crazypatoto/pppc-usb-hub/PCB/pppc_usb_hub/BOM.xlsx

Reference | Value | Datasheet | Footprint | Qty | DNP | MSRP | Total
C1,C2,C3,C4,C5,C11,C25 | 0.1uF | https://www.lcsc.com/product-detail/Multilayer-Ceramic-Capacitors-MLCC-SMD-SMT_Samsung-Electro-Mechanics-CL10B104KB8NNNC_C1591.html | Capacitor_SMD:C_0201_0603Metric | 7 |  | 0.0024 | 3.8712
C6,C7,C23,C24 | 20pF | https://www.lcsc.com/product-detail/Multilayer-Ceramic-Capacitors-MLCC-SMD-SMT_FH-Guangdong-Fenghua-Advanced-Tech-0603CG200F500NT_C165732.html | Capacitor_SMD:C_0201_0603Metric | 4 |  | 0.014
C8,C9,C10,C20 | 10uF | https://www.lcsc.com/product-detail/Multilayer-Ceramic-Capacitors-MLCC-SMD-SMT_Samsung-Electro-Mechanics-CL10A106MQ8NNNC_C1691.html | Capacitor_SMD:C_0201_0603Metric | 4 |  | 0.0044
C12,C13,C14,C22 | 220uF | https://www.lcsc.com/product-detail/Solid-Capacitors_Honor-Elec-HV1E227M0607PZ_C5246541.html | Capacitor_SMD:CP_Elec_6.3x7.7 | 4 |  | 0.1408
C15 | 4.7uF | https://www.lcsc.com/product-detail/Multilayer-Ceramic-Capacitors-MLCC-SMD-SMT_Samsung-Electro-Mechanics-CL10A475KQ8NNNC_C8032.html | Capacitor_SMD:C_0201_0603Metric | 1 |  | 0.0041
C16,C17 | 100nF | https://www.lcsc.com/product-detail/Multilayer-Ceramic-Capacitors-MLCC-SMD-SMT_Samsung-Electro-Mechanics-CL10B104KB8NNNC_C1591.html | Capacitor_SMD:C_0201_0603Metric | 2 |  | 0.0024
C18 | 10nF | https://www.lcsc.com/product-detail/Multilayer-Ceramic-Capacitors-MLCC-SMD-SMT_YAGEO-CC0603KRX7R9BB103_C100042.html | Capacitor_SMD:C_0201_0603Metric | 1 |  | 0.0019
C19 | 1uF | https://www.lcsc.com/product-detail/Multilayer-Ceramic-Capacitors-MLCC-SMD-SMT_Samsung-Electro-Mechanics-CL10A105KB8NNNC_C15849.html | Capacitor_SMD:C_0201_0603Metric | 1 |  | 0.0042
C21 | 22uF | https://www.lcsc.com/product-detail/Tantalum-Capacitors_KEMET-T491A226K006AT_C118989.html | Capacitor_Tantalum_SMD:CP_EIA-3216-10_Kemet-I | 1 |  | 0.0801
D1 | 1N4007 | https://www.lcsc.com/product-detail/Diodes-General-Purpose_MSKSEMI-1N4007-A7_C2902912.html | Diode_SMD:D_SOD-123F | 1 |  | 0.0038
D2 | POWER | https://www.lcsc.com/product-detail/Light-Emitting-Diodes-LED_XINGLIGHT-XL-1608UOC-06_C965800.html | LED_SMD:LED_0201_0603Metric | 1 |  | 0.0051
D3 | USB1 | https://www.lcsc.com/product-detail/Light-Emitting-Diodes-LED_XINGLIGHT-XL-1608UWC-04_C965808.html | LED_SMD:LED_0201_0603Metric | 1 |  | 0.0053
D4 | USB2 | https://www.lcsc.com/product-detail/Light-Emitting-Diodes-LED_XINGLIGHT-XL-1608UWC-04_C965808.html | LED_SMD:LED_0201_0603Metric | 1 |  | 0.0053
D5 | USB3 | https://www.lcsc.com/product-detail/Light-Emitting-Diodes-LED_XINGLIGHT-XL-1608UWC-04_C965808.html | LED_SMD:LED_0201_0603Metric | 1 |  | 0.0053
D6 | RELAY | https://www.lcsc.com/product-detail/Light-Emitting-Diodes-LED_XINGLIGHT-XL-1608UWC-04_C965808.html | LED_SMD:LED_0201_0603Metric | 1 |  | 0.0053
F1 | Polyfuse | https://www.lcsc.com/product-detail/Resettable-Fuses_LUTE-0805L125-6NR_C7499987.html | Capacitor_SMD:C_0805_2012Metric | 1 |  | 0.0584
FB1,FB2 | BLM21PG221SN1D | https://www.lcsc.com/product-detail/Ferrite-Beads_Murata-Electronics-BLM21PG221SN1D_C85840.html | Fuse:Fuse_0805_2012Metric | 2 |  | 0.0148
J1,J2 | USB_C_Signal | https://www.lcsc.com/product-detail/USB-Connectors_SHOU-HAN-TYPE-C-16PIN-2MD-073_C2765186.html | PCBLIB_USB-C-SMD_TYPE-C-6PIN-2MD-073_2024-05-18:USB-C-SMD_TYPE-C-6PIN-2MD-073 | 2 |  | 0.0501
J3 | USB_A_1 | https://www.lcsc.com/product-detail/USB-Connectors_SHOU-HAN-AF-10-0-HC6-3_C456017.html | PCBLIB_USB-A-TH_AF-10.0-HC6.3_2024-05-20:USB-A-TH_AF-10.0-HC6.3 | 1 |  | 0.0362
J4 | USB_A_2 | https://www.lcsc.com/product-detail/USB-Connectors_Ckmtw-Shenzhen-Cankemeng-U-USBAS04P-F001_C386737.html | PCBLIB_USB-A-TH_USB-M-22_2024-05-19:USB-A-TH_USB-M-22 | 1 |  | 0.1504
J5 | USB_A_3 | https://www.lcsc.com/product-detail/USB-Connectors_Ckmtw-Shenzhen-Cankemeng-U-USBAS04P-F001_C386737.html | PCBLIB_USB-A-TH_USB-M-22_2024-05-19:USB-A-TH_USB-M-22 | 1 |  | 0.1504
J6 | Con_Relay | https://www.lcsc.com/product-detail/Screw-terminal_DORABO-DB128L-5-08-3P-OG-S_C430604.html | PCBLIB_CONN-TH_3P-P5.08_DB128L-5.08-3P-OG-S_2024-05-19:CONN-TH_3P-P5.08_DB128L-5.08-3P-OG-S | 1 |  | 0.1801
J7 | Conn_UART | https://www.lcsc.com/product-detail/Pin-Headers_Hanbo-Electronic-HB-PH3-25415PB2GOP_C6332198.html | Connector_PinHeader_2.54mm:PinHeader_1x05_P2.54mm_Vertical | 1 |  | 0.0223
J8 | Conn_Debug | ~ | Connector_PinHeader_2.54mm:PinHeader_1x03_P2.54mm_Vertical | 1
K1 | Relay | https://www.lcsc.com/product-detail/Power-Relays_Ningbo-Songle-Relay-SRD-05VDC-SL-C_C35449.html | Relay_THT:Relay_SPDT_SANYOU_SRD_Series_Form_C | 1 |  | 0.3124
Q1 | DMG2305UX | https://www.lcsc.com/product-detail/MOSFETs_TECH-PUBLIC-DMG2305UX_C2940629.html | Package_TO_SOT_SMD:SOT-23 | 1 |  | 0.0517
Q2 | DMMT5401 | https://www.lcsc.com/product-detail/Bipolar-Transistors-BJT_Diodes-Incorporated-DMMT5401-7-F_C154733.html | Package_TO_SOT_SMD:SOT-23-6 | 1 |  | 0.1683
Q3 | AO3400A | https://www.lcsc.com/product-detail/MOSFETs_UMW-Youtai-Semiconductor-Co-Ltd-AO3400A_C347475.html | Package_TO_SOT_SMD:SOT-23 | 1 |  | 0.0278
R1,R2,R3 | 4.53k | https://www.lcsc.com/product-detail/Chip-Resistor-Surface-Mount_FH-Guangdong-Fenghua-Advanced-Tech-RS-03K4531FT_C321916.html | Resistor_SMD:R_0201_0603Metric | 3 |  | 0.0012
R4,R5,R12,R13 | 5.1k | https://www.lcsc.com/product-detail/Chip-Resistor-Surface-Mount_UNI-ROYAL-Uniroyal-Elec-0603WAF5101T5E_C23186.html | Resistor_SMD:R_0201_0603Metric | 4 |  | 0.0010
R6,R7,R8,R19,R20,R22 | 10k | https://www.lcsc.com/product-detail/Chip-Resistor-Surface-Mount_UNI-ROYAL-Uniroyal-Elec-0603WAF1002T5E_C25804.html | Resistor_SMD:R_0201_0603Metric | 6 |  | 0.0009
R9,R10,R11 | 0R | ~ | Resistor_SMD:R_0201_0603Metric | 3
R14,R15,R16,R17,R18 | 330 | https://www.lcsc.com/product-detail/Chip-Resistor-Surface-Mount_UNI-ROYAL-Uniroyal-Elec-0603WAF3300T5E_C23138.html | Resistor_SMD:R_0201_0603Metric | 5 |  | 0.001
R21 | 47k | https://www.lcsc.com/product-detail/Chip-Resistor-Surface-Mount_UNI-ROYAL-Uniroyal-Elec-0603WAF4701T5E_C23162.html | Resistor_SMD:R_0201_0603Metric | 1 |  | 0.001
SW1 | USB1 | https://www.lcsc.com/product-detail/Tactile-Switches_G-Switch-GT-TC020B-H035-L05_C17179534.html | PCBLIB_SW-SMD_GT-TC020B-H035-L05_2024-05-21:SW-SMD_GT-TC020B-H035-L05 | 1 |  | 0.0726
SW2 | USB2 | https://www.lcsc.com/product-detail/Tactile-Switches_G-Switch-GT-TC020B-H035-L05_C17179534.html | PCBLIB_SW-SMD_GT-TC020B-H035-L05_2024-05-21:SW-SMD_GT-TC020B-H035-L05 | 1 |  | 0.0726
SW3 | USB3 | https://www.lcsc.com/product-detail/Tactile-Switches_G-Switch-GT-TC020B-H035-L05_C17179534.html | PCBLIB_SW-SMD_GT-TC020B-H035-L05_2024-05-21:SW-SMD_GT-TC020B-H035-L05 | 1 |  | 0.0726
SW4 | BOOT0 | https://www.lcsc.com/product-detail/Tactile-Switches_XKB-Connection-TS-1101-C-W_C318938.html | PCBLIB_SW-SMD_L6.0-W3.3-LS8.0_2024-05-19:SW-SMD_L6.0-W3.3-LS8.0 | 1 |  | 0.0323
SW5 | RESET | https://www.lcsc.com/product-detail/Tactile-Switches_XKB-Connection-TS-1101-C-W_C318938.html | PCBLIB_SW-SMD_L6.0-W3.3-LS8.0_2024-05-19:SW-SMD_L6.0-W3.3-LS8.0 | 1 |  | 0.0323
U1,U2,U3 | MT9700 | https://www.lcsc.com/product-detail/span-style-background-color-ff0-Power-span-Distribution-Switches_XI-AN-Aerosemi-Tech-MT9700_C89855.html | PCBLIB_SOT-23-5_L3.0-W1.7-P0.95-LS2.8-BR_2024-05-18:SOT-23-5_L3.0-W1.7-P0.95-LS2.8-BR | 3 |  | 0.0356
U4 | SL2.1s | https://www.lcsc.com/product-detail/USB-Converters_CoreChips-SL2-1s_C2684433.html | PCB_NEW_PCB_2024-05-14:SSOP-16_L4.6-W2.6-P0.53-LS4.0-BL | 1 |  | 0.205
U5 | AMS1117-3.3 | https://www.lcsc.com/product-detail/Linear-Voltage-Regulators-LDO_Advanced-Monolithic-Systems-AMS1117-3-3_C6186.html | Package_TO_SOT_SMD:SOT-223-3_TabPin2 | 1 |  | 0.1298
U6 | STM32F042F6Px | https://www.lcsc.com/product-detail/Microcontroller-Units-MCUs-MPUs-SOCs_STMicroelectronics-STM32F042F6P6TR_C2969989.html | Package_SO:TSSOP-20_4.4x6.5mm_P0.65mm | 1 |  | 1.1458
XTAL1,XTAL2 | 12MHz | https://www.lcsc.com/product-detail/Crystals_YXC-X322512MSB4SI_C9002.html | PCBLIB_OSC-SMD_4P-L3.2-W2.5-BL_2024-05-18:OSC-SMD_4P-L3.2-W2.5-BL | 2 |  | 0.0571
