crazypatoto/pppc-usb-hub/PCB/3d_models/TactileButton(6x3,5mm)_SMD.stp

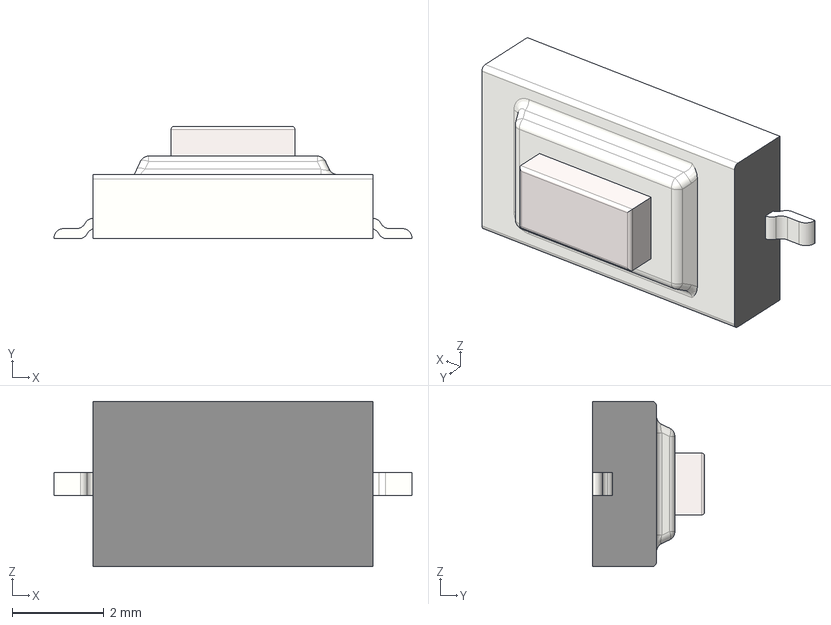
[picture p1: CAD file, 2024-05-30]
PCB/3d_models/TactileButton(6x3,5mm)_SMD.stp
7.80 x 2.45 x 3.60 mm
