crazypatoto/pppc-usb-hub/PCB/SLOT.dxf

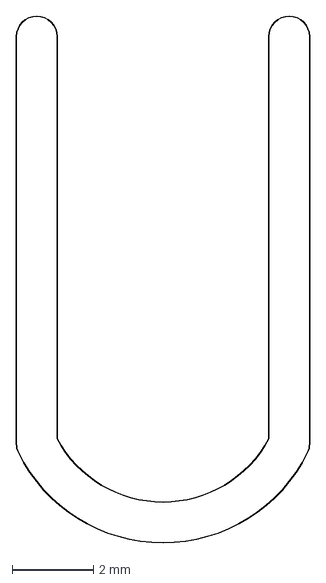
[picture p2: CAD file, 2024-05-30]
PCB/SLOT.dxf
7.20 x 12.9 mm
