crazypatoto/pppc-usb-hub/PCB/3d_models/dg-301-5_0.step

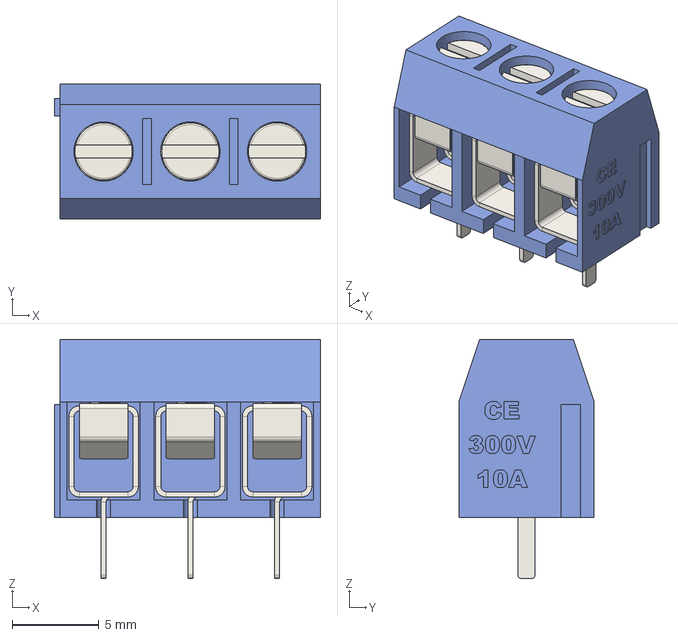
[picture p3: CAD file, 2024-05-22]
PCB/3d_models/dg-301-5_0.step
15.3 x 7.80 x 13.8 mm
