crazypatoto/pppc-usb-hub/PCB/PCB_Outline.dxf

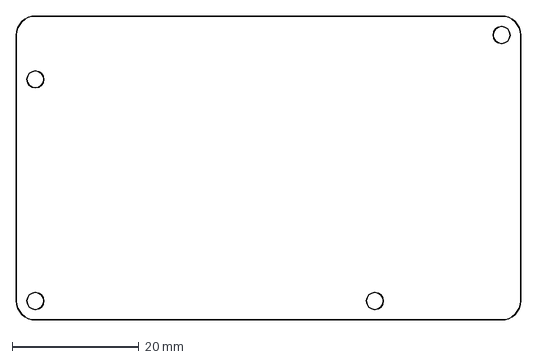
[picture p4: CAD file, 2024-05-30]
PCB/PCB_Outline.dxf
79.6 x 48.0 mm
