crazypatoto/pppc-usb-hub/PCB/3d_models/usb1125-gf-b.stp

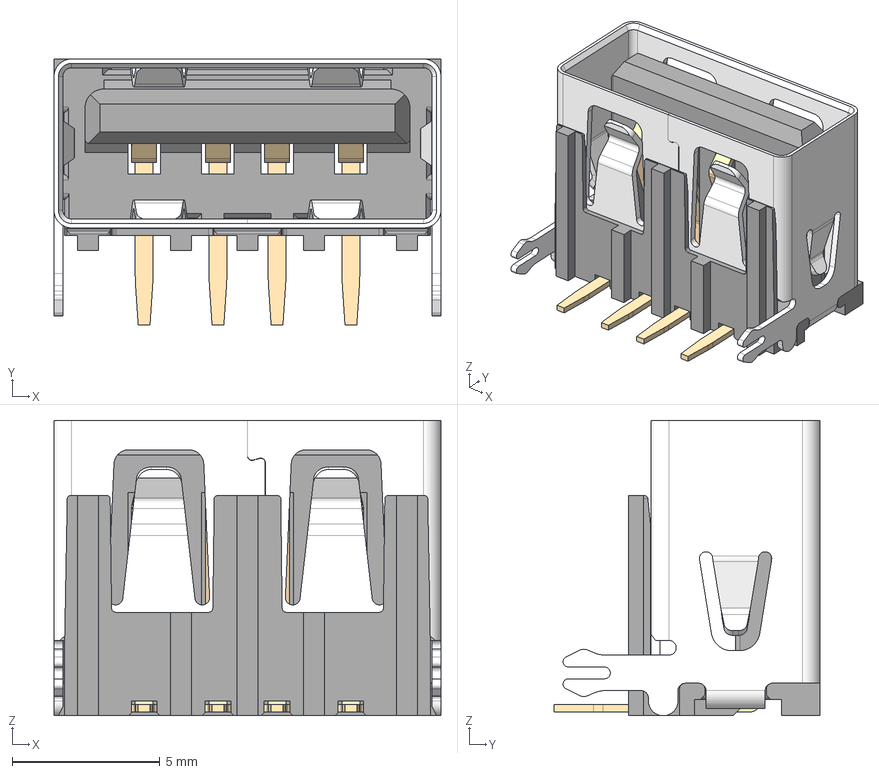
[picture p5: CAD file, 2024-05-22]
PCB/3d_models/usb1125-gf-b.stp
13.1 x 9.01 x 10.0 mm
