crazypatoto/pppc-usb-hub/PCB/3d_models/USB-A-S-F-B-VT.stp

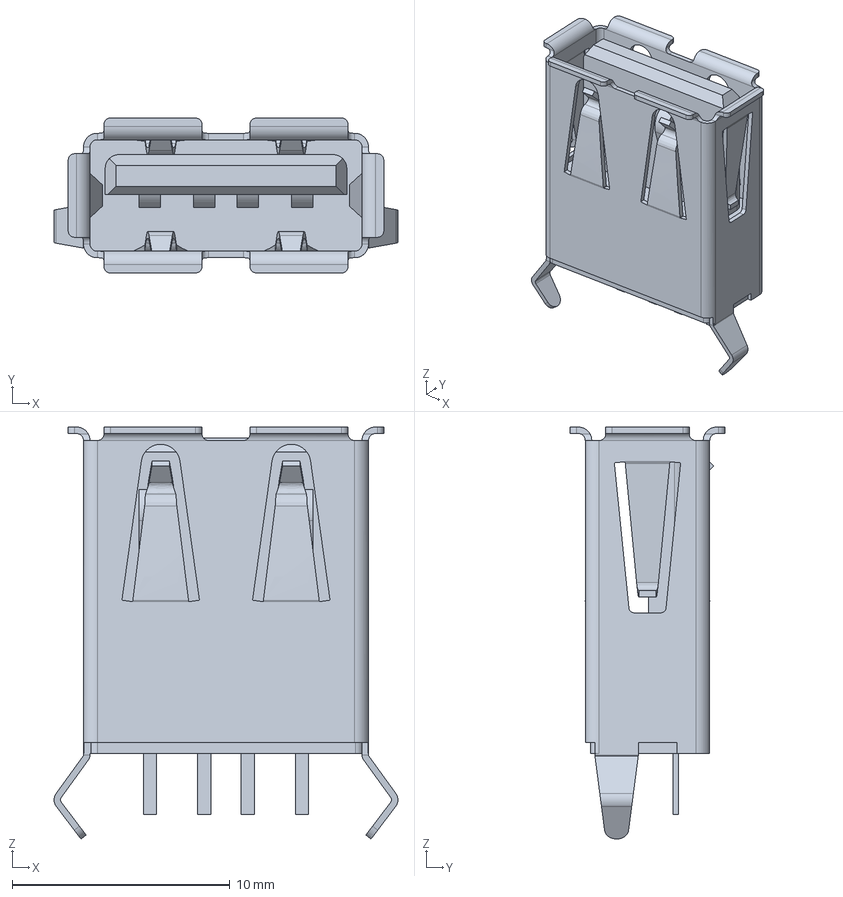
[picture p6: CAD file, 2024-05-22]
PCB/3d_models/USB-A-S-F-B-VT.stp
15.8 x 7.12 x 18.9 mm
