crazypatoto/pppc-usb-hub/PCB/pppc_usb_hub/pppc_usb_hub.kicad_pcb

## KiCad design PCB/pppc_usb_hub/pppc_usb_hub.kicad_pcb (2024-06-25)

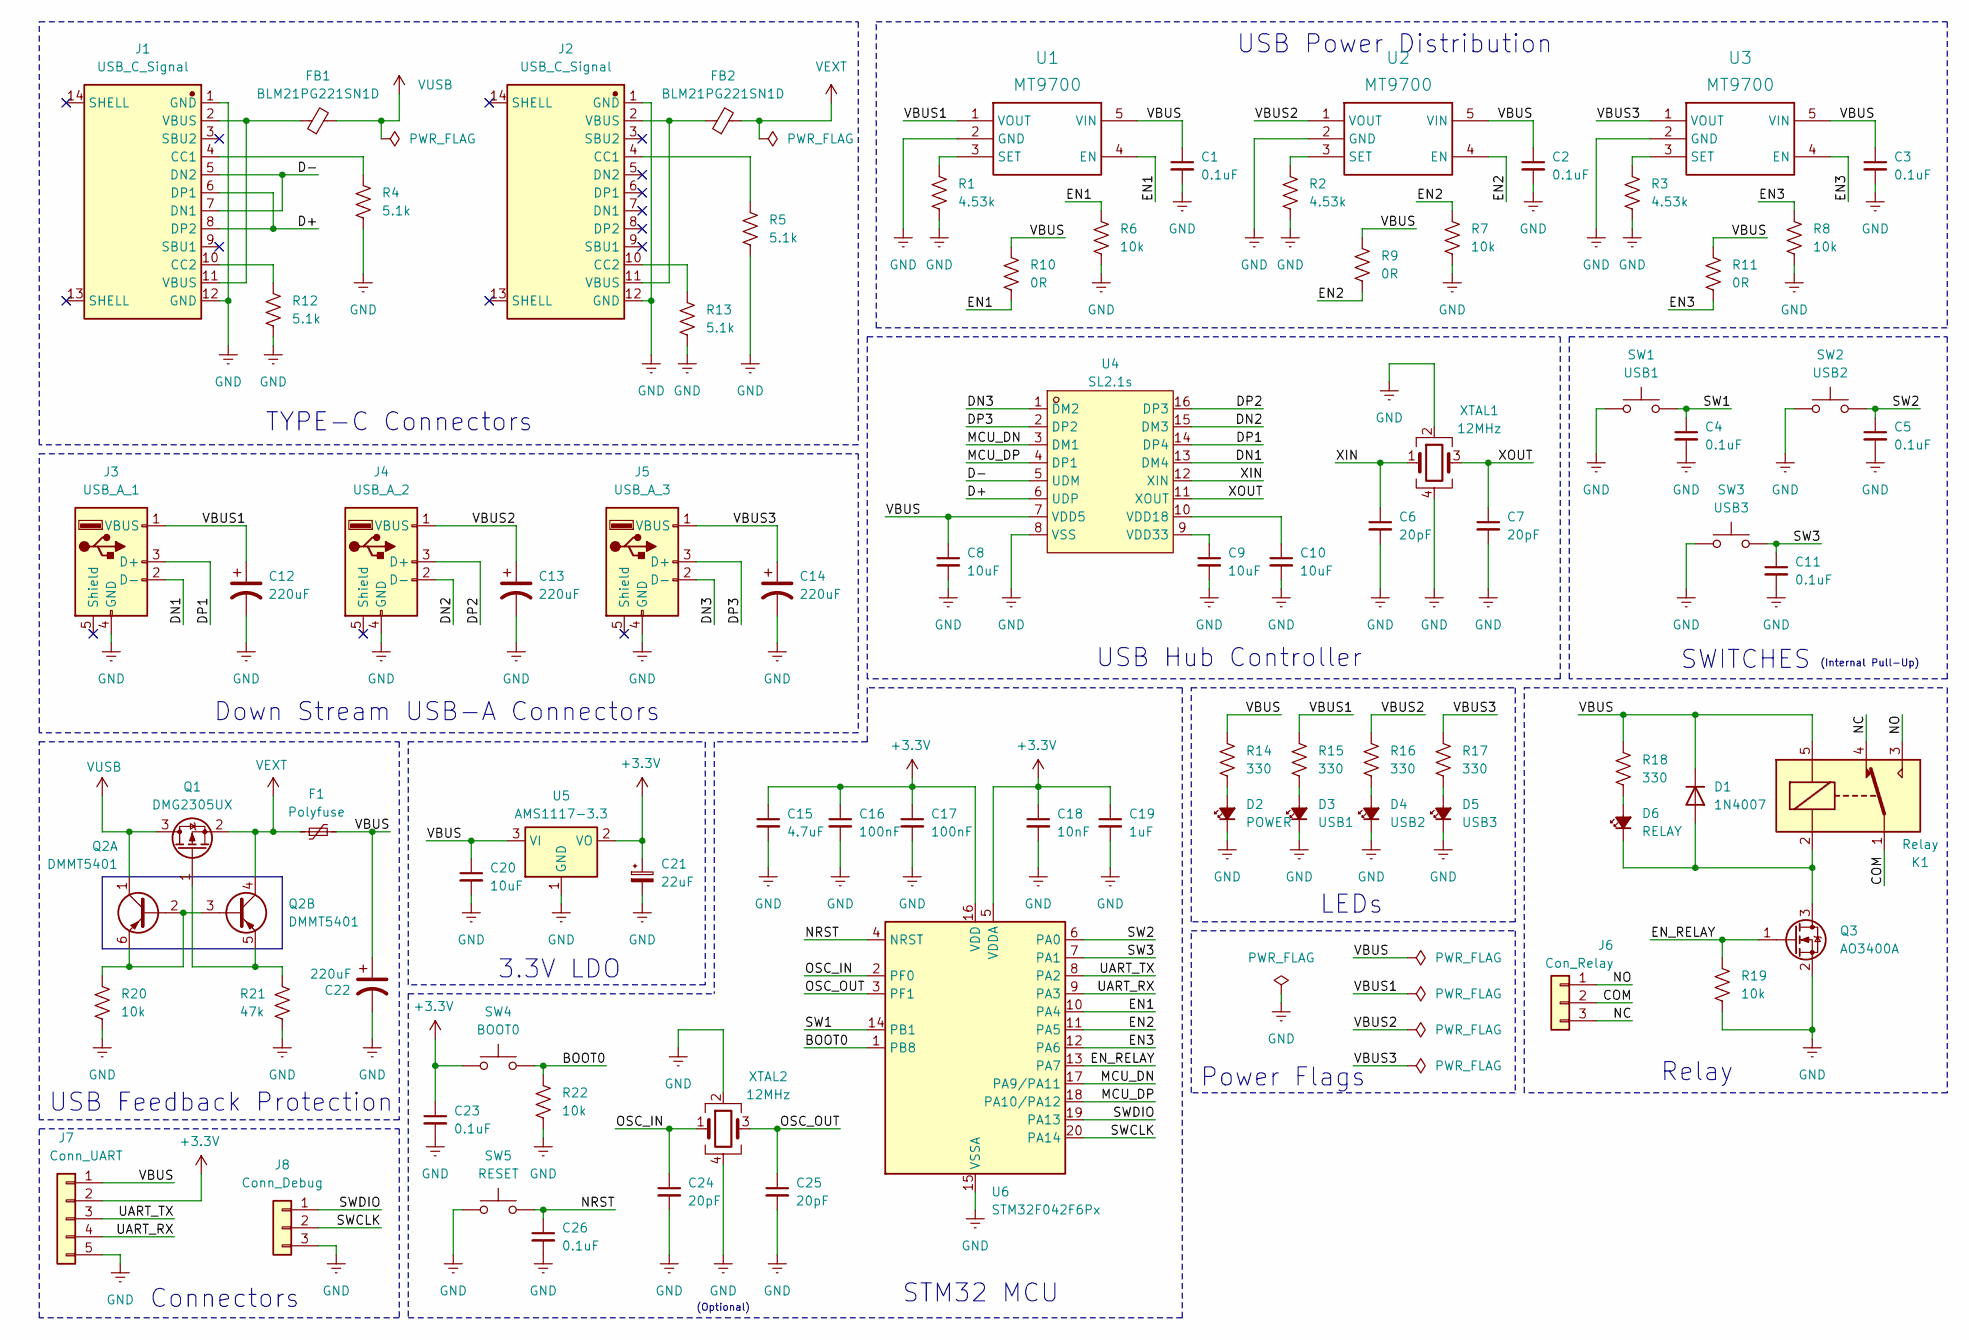
[picture p7: schematic pppc_usb_hub.kicad_sch, Per-Port Power Control USB Hub]

Parts:
C1, C2, C3, C4, C5, C11, C23, C26: 0.1uF; C_0603_1608Metric
C6, C7, C24, C25: 20pF; C_0603_1608Metric
C8, C9, C10, C20: 10uF; C_0603_1608Metric
C12, C13, C14, C22: 220uF; CP_Elec_6.3x7.7
C15: 4.7uF; C_0603_1608Metric
C16, C17: 100nF; C_0603_1608Metric
C18: 10nF; C_0603_1608Metric
C19: 1uF; C_0603_1608Metric
C21: 22uF; CP_EIA-3216-10_Kemet-I
D1: 1N4007; D_SOD-123F
D2: POWER; LED_0603_1608Metric
D3: USB1; LED_0603_1608Metric
D4: USB2; LED_0603_1608Metric
D5: USB3; LED_0603_1608Metric
D6: RELAY; LED_0603_1608Metric
F1: Polyfuse; C_0805_2012Metric
FB1, FB2: BLM21PG221SN1D; Fuse_0805_2012Metric
J1, J2: USB_C_Signal; USB-C-SMD_TYPE-C-6PIN-2MD-073
J3: USB_A_1; USB-A-TH_AF-10.0-HC6.3
J4: USB_A_2; USB-A-TH_USB-M-22
J5: USB_A_3; USB-A-TH_USB-M-22
J6: Con_Relay; CONN-TH_3P-P5.08_DB128L-5.08-3P-OG-S
J7: Conn_UART; PinHeader_1x05_P2.54mm_Vertical
J8: Conn_Debug; PinHeader_1x03_P2.54mm_Vertical
K1: Relay; Relay_SPDT_SANYOU_SRD_Series_Form_C
Q1: DMG2305UX; SOT-23
Q2: DMMT5401; SOT-23-6
Q3: AO3400A; SOT-23
R1, R2, R3: 4.53k; R_0603_1608Metric
R4, R5, R12, R13: 5.1k; R_0603_1608Metric
R6, R7, R8, R19, R20, R22: 10k; R_0603_1608Metric
R9, R10, R11: 0R; R_0603_1608Metric
R14, R15, R16, R17, R18: 330; R_0603_1608Metric
R21: 47k; R_0603_1608Metric
SW1: USB1; SW-SMD_GT-TC020B-H035-L05
SW2: USB2; SW-SMD_GT-TC020B-H035-L05
SW3: USB3; SW-SMD_GT-TC020B-H035-L05
SW4: BOOT0; SW-SMD_GT-TC020B-H035-L05
SW5: RESET; SW-SMD_L6.0-W3.3-LS8.0
U1, U2, U3: MT9700; SOT-23-5_L3.0-W1.7-P0.95-LS2.8-BR
U4: SL2.1s; SSOP-16_L4.6-W2.6-P0.53-LS4.0-BL
U5: AMS1117-3.3; SOT-223-3_TabPin2
U6: STM32F042F6Px; TSSOP-20_4.4x6.5mm_P0.65mm
XTAL1, XTAL2: 12MHz; OSC-SMD_4P-L3.2-W2.5-BL

Connections:
+3.3V: C15.1, C16.1, C17.1, C18.1, C19.1, C21.1, C23.1, J7.2, SW4.2, U5.2 (VO), U6.5 (VDDA), U6.16 (VDD)
/BOOT0: R22.1, SW4.1, U6.1 (PB8)
/COM: J6.2, K1.1
/D+: J1.6 (DP1), J1.8 (DP2), U4.6 (UDP)
/D-: J1.5 (DN2), J1.7 (DN1), U4.5 (UDM)
/DN1: J3.2 (D-), U4.13 (DM4)
/DN2: J4.2 (D-), U4.15 (DM3)
/DN3: J5.2 (D-), U4.1 (DM2)
/DP1: J3.3 (D+), U4.14 (DP4)
/DP2: J4.3 (D+), U4.16 (DP3)
/DP3: J5.3 (D+), U4.2 (DP2)
/EN1: R6.1, R10.2, U1.4 (EN), U6.10 (PA4)
/EN2: R7.1, R9.2, U2.4 (EN), U6.11 (PA5)
/EN3: R8.1, R11.2, U3.4 (EN), U6.12 (PA6)
/EN_RELAY: Q3.1 (G), R19.1, U6.13 (PA7)
/MCU_DN: U4.3 (DM1), U6.17 (PA9/PA11)
/MCU_DP: U4.4 (DP1), U6.18 (PA10/PA12)
/NC: J6.3, K1.4
/NO: J6.1, K1.3
/NRST: C26.1, SW5.1, U6.4 (NRST)
/OSC_IN: C24.1, U6.2 (PF0), XTAL2.1
/OSC_OUT: C25.1, U6.3 (PF1), XTAL2.3
/SW1: C4.1, SW1.1, U6.14 (PB1)
/SW2: C5.1, SW2.1, U6.6 (PA0)
/SW3: C11.1, SW3.1, U6.7 (PA1)
/SWCLK: J8.2, U6.20 (PA14)
/SWDIO: J8.1, U6.19 (PA13)
/UART_RX: J7.4, U6.9 (PA3)
/UART_TX: J7.3, U6.8 (PA2)
/VBUS: C1.1, C2.1, C3.1, C8.1, C20.1, C22.1, D1.1 (K), F1.2, J7.1, K1.5, R9.1, R10.1, R11.1, R14.1, R18.1, U1.5 (VIN), U2.5 (VIN), U3.5 (VIN), U4.7 (VDD5), U5.3 (VI)
/VBUS1: C12.1, J3.1 (VBUS), R15.1, U1.1 (VOUT)
/VBUS2: C13.1, J4.1 (VBUS), R16.1, U2.1 (VOUT)
/VBUS3: C14.1, J5.1 (VBUS), R17.1, U3.1 (VOUT)
/XIN: C6.1, U4.12 (XIN), XTAL1.1
/XOUT: C7.1, U4.11 (XOUT), XTAL1.3
GND: C1.2, C2.2, C3.2, C4.2, C5.2, C6.2, C7.2, C8.2, C9.2, C10.2, C11.2, C12.2, C13.2, C14.2, C15.2, C16.2, C17.2, C18.2, C19.2, C20.2, C21.2, C22.2, C23.2, C24.2, C25.2, C26.2, D2.1 (K), D3.1 (K), D4.1 (K), D5.1 (K), J1.1 (GND), J1.12 (GND), J2.1 (GND), J2.12 (GND), J3.4 (GND), J4.4 (GND), J5.4 (GND), J7.5, J8.3, Q3.2 (S), R1.2, R2.2, R3.2, R4.2, R5.2, R6.2, R7.2, R8.2, R12.2, R13.2, R19.2, R20.2, R21.2, R22.2, SW1.2, SW2.2, SW3.2, SW5.2, U1.2 (GND), U2.2 (GND), U3.2 (GND), U4.8 (VSS), U5.1 (GND), U6.15 (VSSA), XTAL1.2, XTAL1.4, XTAL2.2, XTAL2.4
unnamed: D1.2 (A), D6.1 (K), K1.2, Q3.3 (D)
unnamed: D2.2 (A), R14.2
unnamed: D3.2 (A), R15.2
unnamed: D4.2 (A), R16.2
unnamed: D5.2 (A), R17.2
unnamed: D6.2 (A), R18.2
unnamed: FB1.1, J1.2 (VBUS), J1.11 (VBUS)
unnamed: FB2.1, J2.2 (VBUS), J2.11 (VBUS)
unnamed: J1.4 (CC1), R4.1
unnamed: J1.10 (CC2), R12.1
unnamed: J2.4 (CC1), R5.1
unnamed: J2.10 (CC2), R13.1
unnamed: Q1.1 (G), Q2.5 (E2), R21.1
unnamed: Q2.2 (B1), Q2.3 (B2), Q2.6 (E1), R20.1
unnamed: R1.1, U1.3 (SET)
unnamed: R2.1, U2.3 (SET)
unnamed: R3.1, U3.3 (SET)
unnamed: C10.1, U4.10 (VDD18)
unnamed: C9.1, U4.9 (VDD33)
VEXT: F1.1, FB2.2, Q1.2 (S), Q2.4 (C2)
VUSB: FB1.2, Q1.3 (D), Q2.1 (C1)

Notes on the sheet:
3.3V LDO
Relay
Connectors
(Internal Pull-Up)
Power Flags
(Optional)
LEDs
TYPE-C Connectors
STM32 MCU
USB Hub Controller
Down Stream USB-A Connectors
USB Power Distribution
SWITCHES
USB Feedback Protection

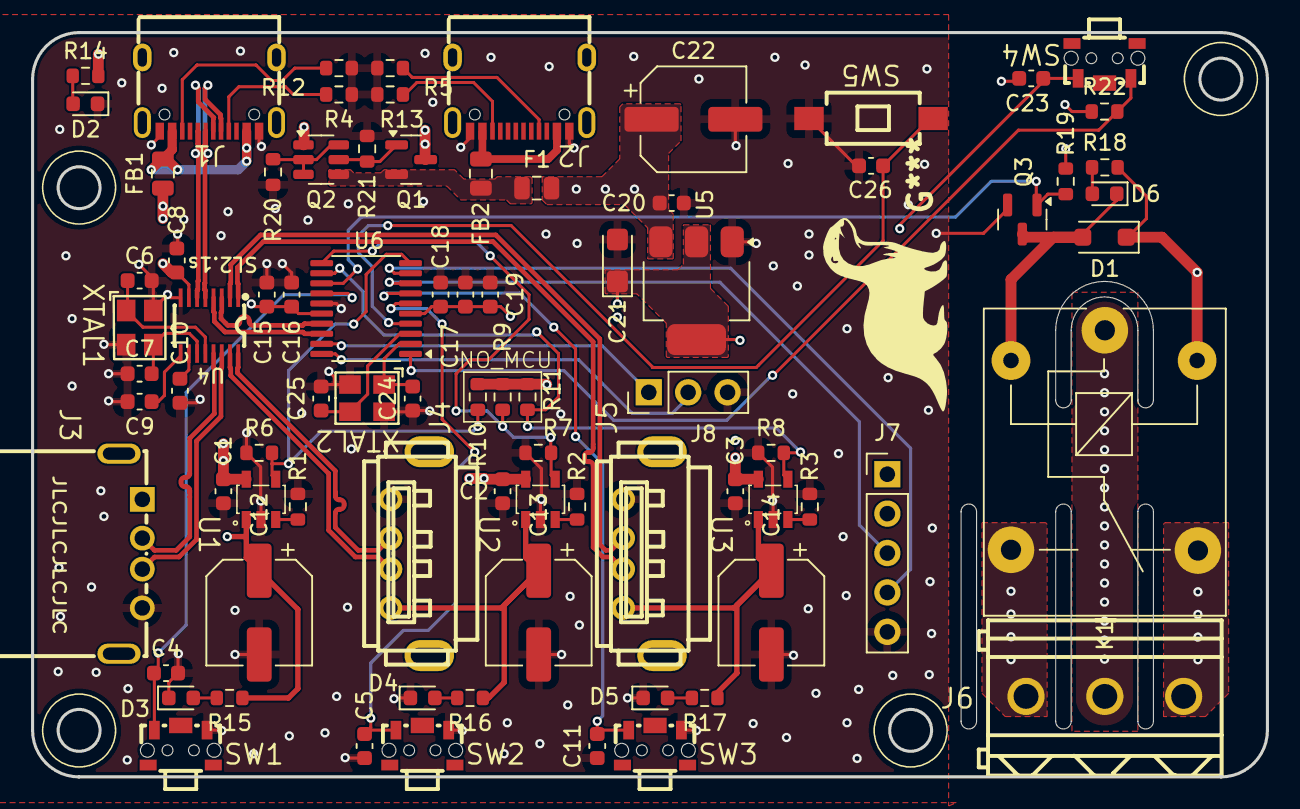
[picture p8: board pppc_usb_hub.kicad_pcb from above]

Board: 4 copper layers, 79.6 x 48.0 mm, 82 parts (0 on the bottom side), 57 nets.
