crazypatoto/pppc-usb-hub/app/Core/Src/main.c

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
/* Includes ------------------------------------------------------------------*/
#include "main.h"
#include "dma.h"
#include "tim.h"
#include "usart.h"
#include "usb_device.h"
#include "gpio.h"

/* USER CODE BEGIN Includes */
#include "usbd_cdc_if.h"
/* USER CODE END Includes */


/* USER CODE BEGIN PV */
extern TIM_HandleTypeDef htim3;
uint8_t CDC_Rx_Buffer[64] = { 0 };
uint8_t rx_count = 0;
uint8_t IO_state = 0;
volatile uint8_t IO_Ctrl_Flag = 0x00;
/* USER CODE END PV */

void SystemClock_Config(void);
/* USER CODE BEGIN PFP */
void Enable_All_IOs();
void Disable_All_IOs();

/* USER CODE END PFP */

/**
 * @brief  The application entry point.
 * @retval int
 */
int main(void) {

	/* MCU Configuration--------------------------------------------------------*/

	/* Reset of all peripherals, Initializes the Flash interface and the Systick. */
	HAL_Init();

	/* Configure the system clock */
	SystemClock_Config();

	/* Initialize all configured peripherals */
	MX_GPIO_Init();
	MX_DMA_Init();
	MX_USART2_UART_Init();
	MX_USB_DEVICE_Init();
	MX_TIM3_Init();
	/* USER CODE BEGIN 2 */
	HAL_TIM_Base_Start_IT(&htim3);
	Enable_All_IOs();
	/* USER CODE END 2 */

	/* Infinite loop */
	/* USER CODE BEGIN WHILE */

	while (1) {
		if (HAL_DMA_PollForTransfer(&hdma_memtomem_dma1_channel1,
				HAL_DMA_FULL_TRANSFER, 100) == HAL_OK) {
			uint32_t temp = *((uint32_t*) CDC_Rx_Buffer);
			if (temp == 0xA20101A0) {
				Disable_All_IOs();
			} else if (temp == 0xA10001A0) {
				Enable_All_IOs();
			}
		}

		/* USER CODE END WHILE */

		/* USER CODE BEGIN 3 */
	}
	/* USER CODE END 3 */
}

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
/* USER CODE BEGIN 4 */

void Enable_All_IOs() {

	IO_Ctrl_Flag = 0x11;
	IO_state = 0x01;
}

void Disable_All_IOs() {

	IO_Ctrl_Flag = 0x01;
    IO_state = 0x00;
}

void IO_Ctrl_Handler() {
	static uint8_t cooldown = 0;

	if(HAL_GPIO_ReadPin(GPIOB, GPIO_PIN_8) && (cooldown == 0))
	{
		if(IO_state){
			Disable_All_IOs();
		}else{
			Enable_All_IOs();
		}
		cooldown = 10;
	}

	switch (IO_Ctrl_Flag) {
	case 0x01:
		HAL_GPIO_WritePin(GPIOA, GPIO_PIN_4, GPIO_PIN_RESET);
		IO_Ctrl_Flag += 1;
		break;
	case 0x02:
		HAL_GPIO_WritePin(GPIOA, GPIO_PIN_5, GPIO_PIN_RESET);
		IO_Ctrl_Flag += 1;
		break;
	case 0x03:
		HAL_GPIO_WritePin(GPIOA, GPIO_PIN_6, GPIO_PIN_RESET);
		IO_Ctrl_Flag += 1;
		break;
	case 0x04:
		HAL_GPIO_WritePin(GPIOA, GPIO_PIN_7, GPIO_PIN_SET);
		IO_Ctrl_Flag = 0x00;
		break;
	case 0x11:
		HAL_GPIO_WritePin(GPIOA, GPIO_PIN_4, GPIO_PIN_SET);
		IO_Ctrl_Flag += 1;
		break;
	case 0x12:
		HAL_GPIO_WritePin(GPIOA, GPIO_PIN_5, GPIO_PIN_SET);
		IO_Ctrl_Flag += 1;
		break;
	case 0x13:
		HAL_GPIO_WritePin(GPIOA, GPIO_PIN_6, GPIO_PIN_SET);
		IO_Ctrl_Flag += 1;
		break;
	case 0x14:
		HAL_GPIO_WritePin(GPIOA, GPIO_PIN_7, GPIO_PIN_RESET);
		IO_Ctrl_Flag = 0x00;
		break;
	default:
		IO_Ctrl_Flag = 0x00;
		break;
	}

	cooldown -= cooldown ? 1 : 0;
}
/* USER CODE END 4 */
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
