crazypatoto/pppc-usb-hub/app/app.ioc

Mcu.UserName=STM32F042F6Px
PA0.Signal=GPIO_Input
PA1.Signal=GPIO_Input
PA11.Signal=USB_DM
PA12.Signal=USB_DP
PA13.Signal=SYS_SWDIO
PA14.Signal=SYS_SWCLK
PA2.Signal=USART2_TX
PA3.Signal=USART2_RX
PA4.Signal=GPIO_Output
PA5.Signal=GPIO_Output
PA6.Signal=GPIO_Output
PA7.Signal=GPIO_Output
PB1.Signal=GPIO_Input
PB8.Signal=GPIO_Input
