crazypatoto/pppc-usb-hub/(commit log)

2024-05-22 Add PCB datas
    [BOM.xlsx, USB-A-S-F-B-VT.stp, dg-301-5_0.step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]
2024-05-30 Rev 2
    [BOM.xlsx, BOM_old.xlsx, PCB_Outline.dxf, SLOT.dxf, TactileButton(6x3,5mm)_SMD.stp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]
2024-06-10 Add firmware and update PCB to Rev 3
    [app Debug.cfg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]
2024-06-13 Add relay control
2024-06-25 Add button control
    [pppc_usb_hub.kicad_pcb]
